dresco/ChickenShack/hardware/manufacturing/README

Notes:

Directory contains symlinks with correct naming convention
Move/copy board outline to silkscreen layer
Add order number to silkscreen layer
Zip up as ordernumber_size.zip (i.e. D12345_5x5.zip)
