dresco/ChickenShack/(list of files, drawings)

Other design files:
hardware/ChickenShack.dsn
