dresco/ChickenShack/hardware/ChickenShack.sch

## KiCad design hardware/ChickenShack.sch (2013-01-05)

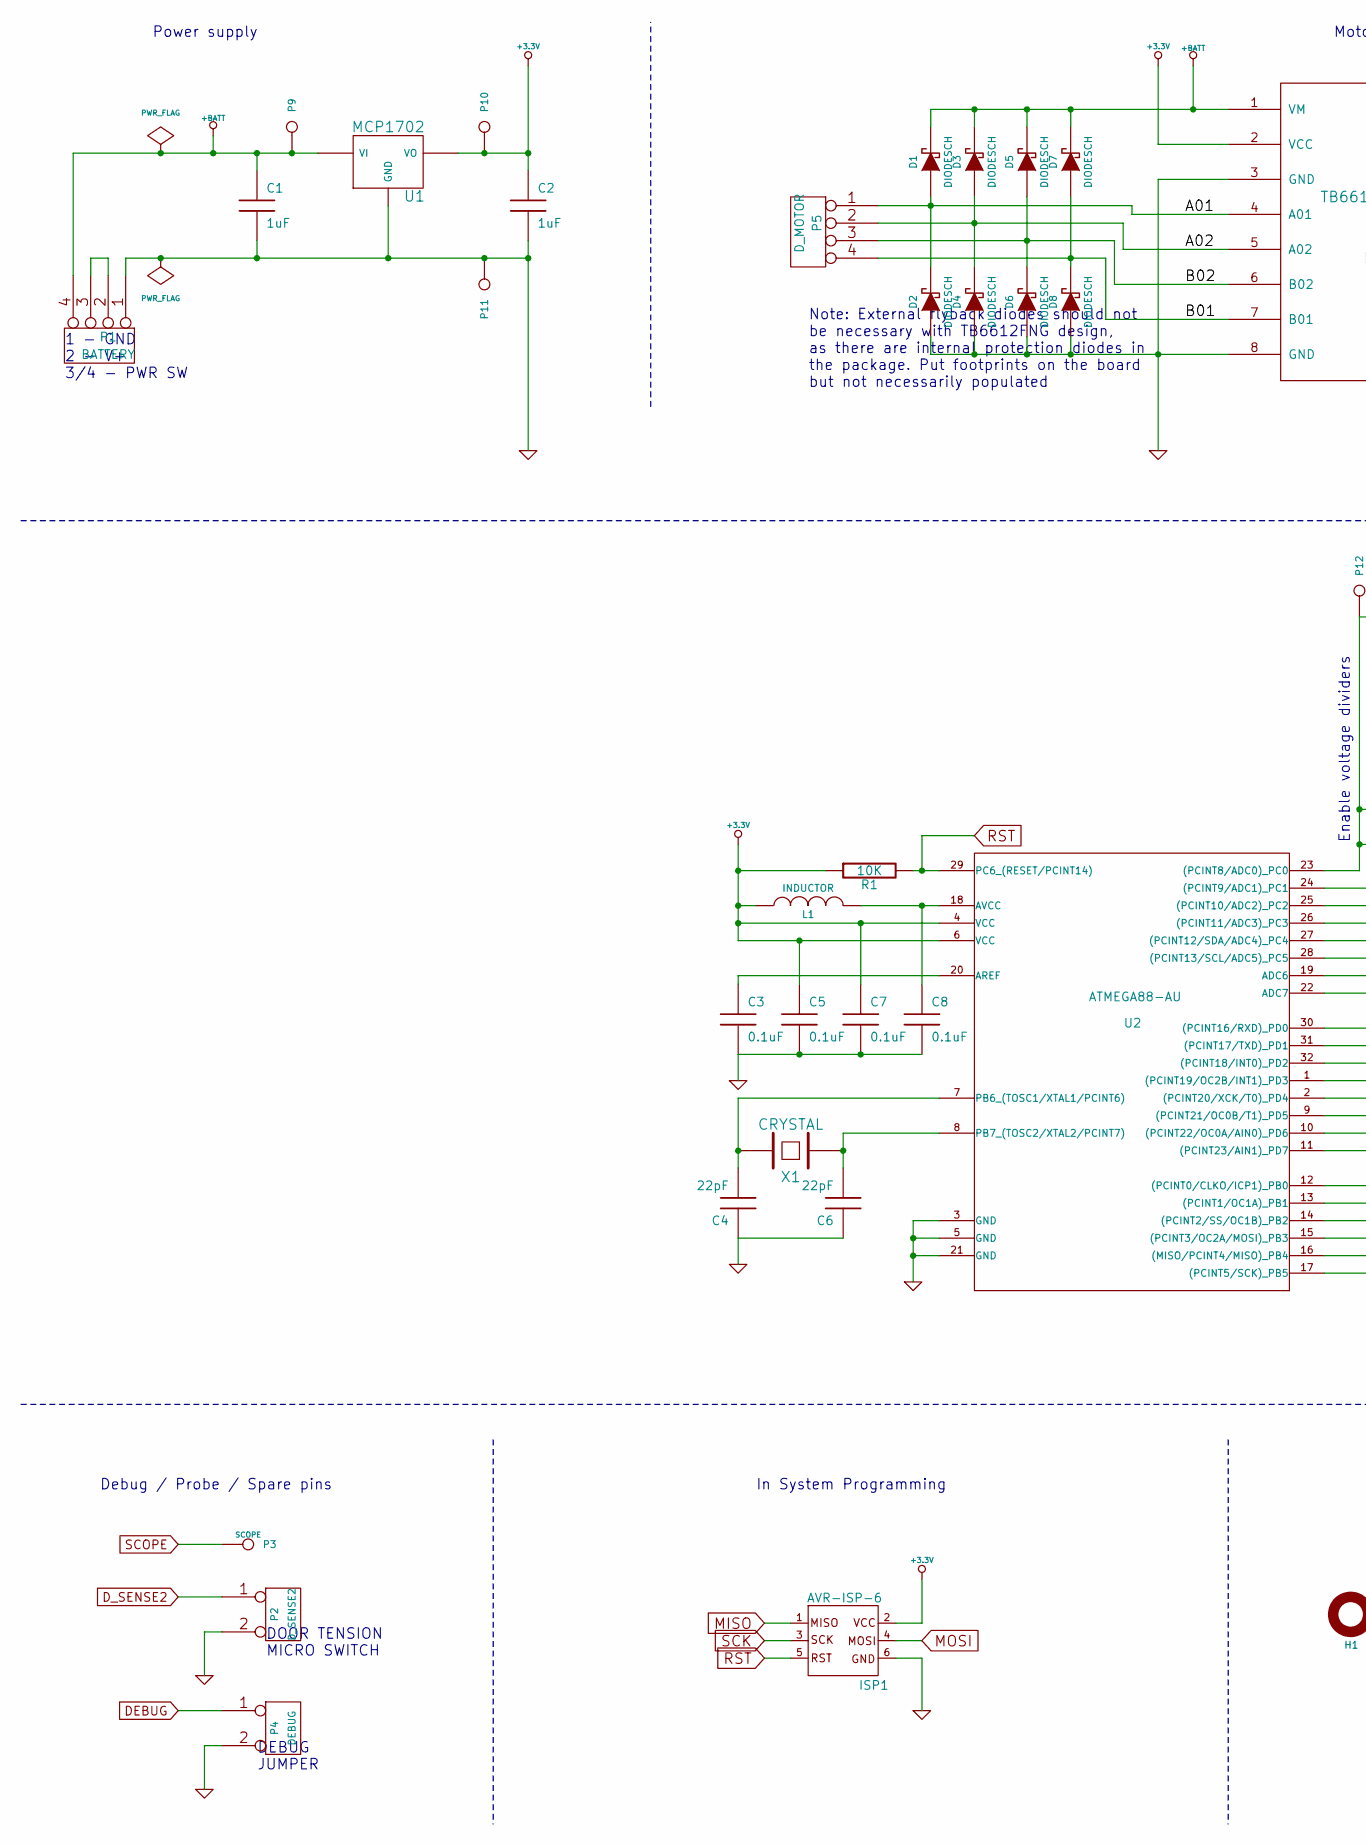
[picture p1: schematic ChickenShack.sch, part in row 1, column 1]

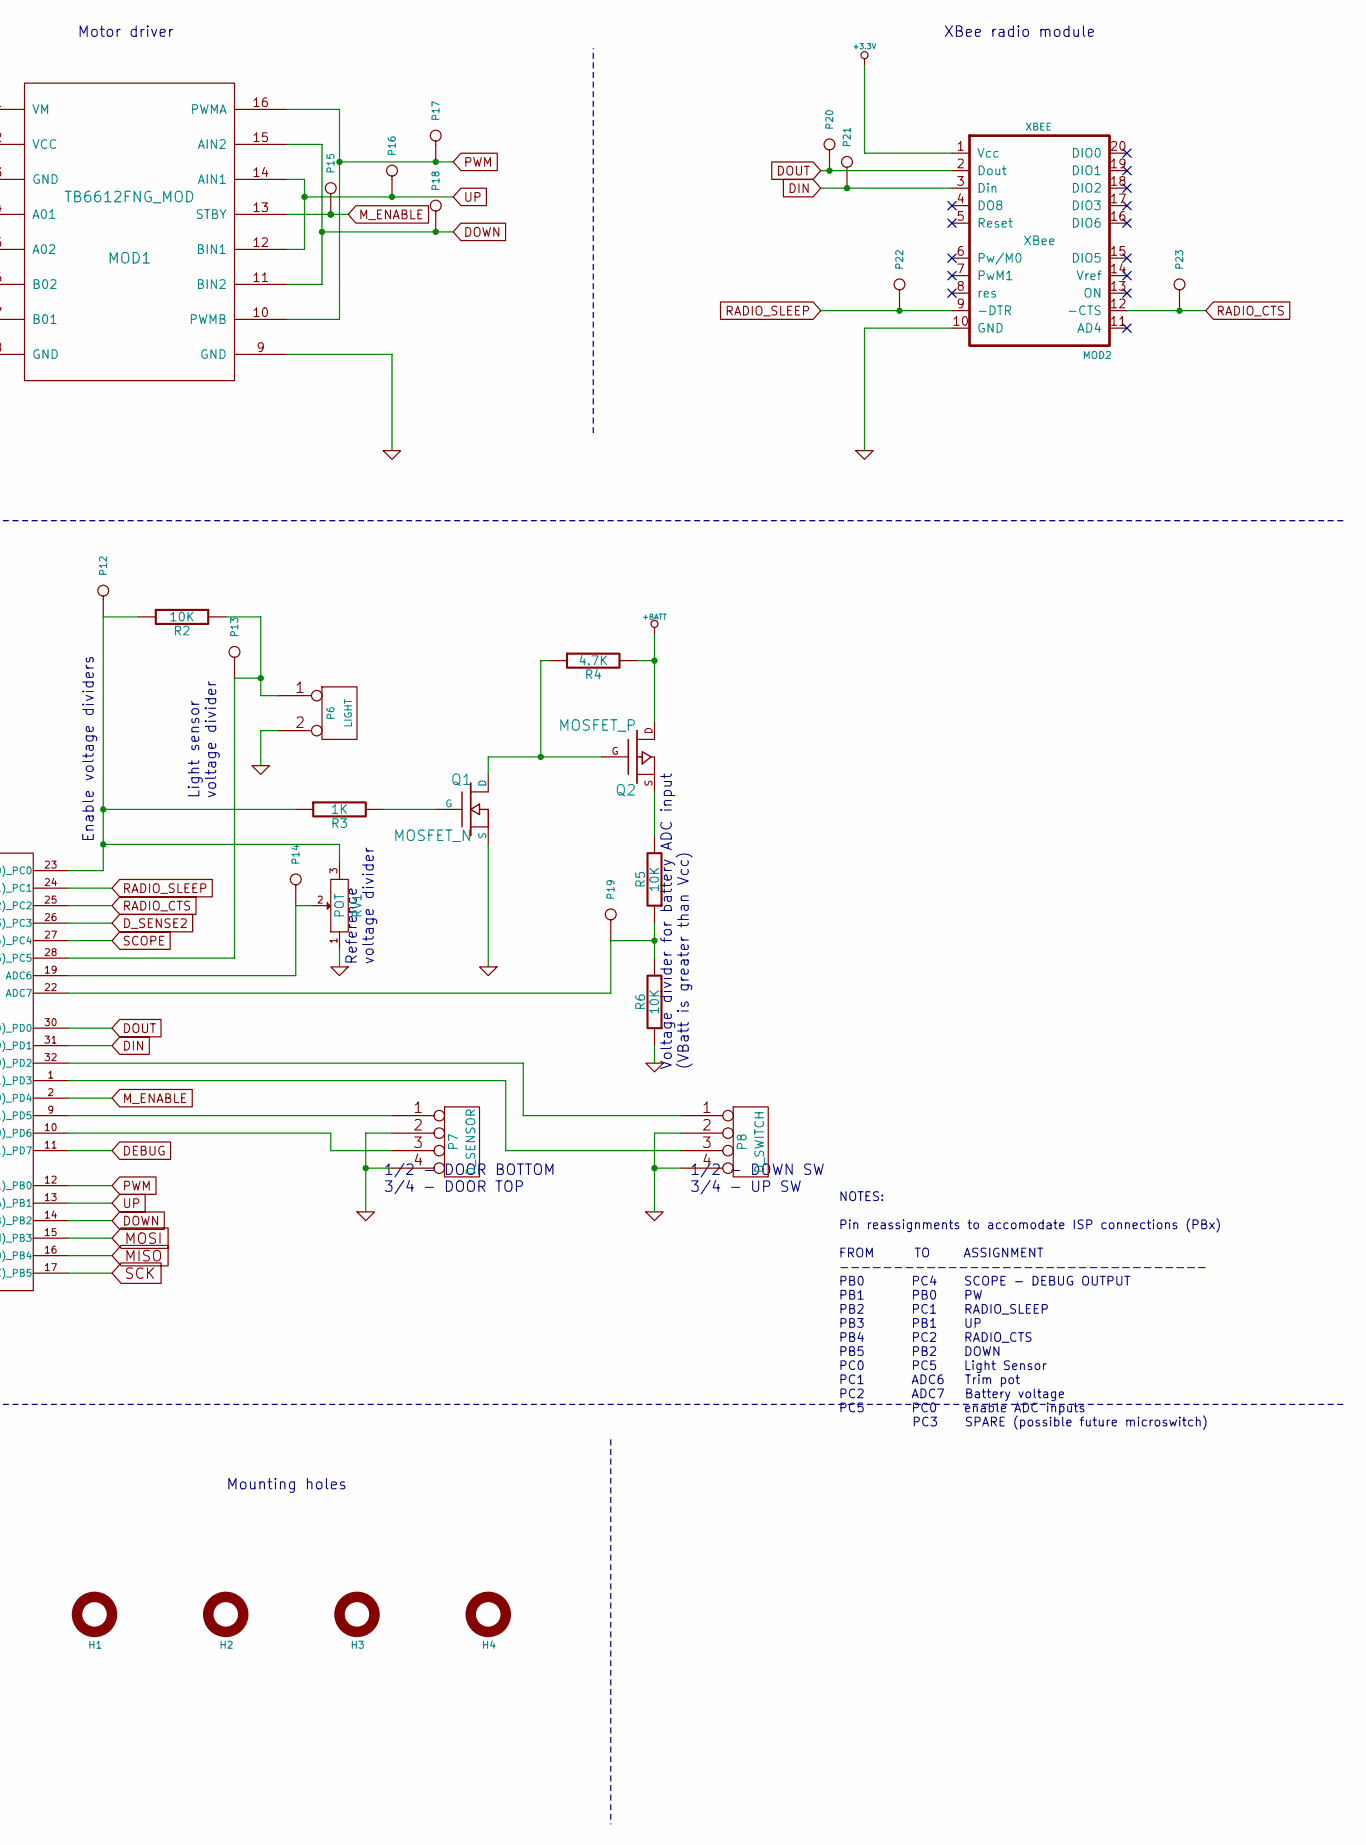
[picture p2: schematic ChickenShack.sch, part in row 1, column 2]

Parts:
C1, C2: 1uF
C3, C5, C7, C8: 0.1uF
C4, C6: 22pF
D1, D2, D3, D4, D5, D6, D7, D8: DIODESCH
H1, H2, H3, H4: HOLE
ISP1: AVR-ISP-6
L1: INDUCTOR
MOD1: TB6612FNG_MOD
MOD2: XBEE; XBee
P1: BATTERY
P2: D_SENSE2
P3: SCOPE
P4: DEBUG
P5: D_MOTOR
P6: LIGHT
P7: D_SENSOR
P8: D_SWITCH
P9, P10, P11, P12, P13, P14, P15, P16, P17, P18, P19, P20, P21, P22, P23: CONN_1
Q1: MOSFET_N
Q2: MOSFET_P
R1, R2, R5, R6: 10K
R3: 1K
R4: 4.7K
RV1: POT
U1: MCP1702
U2: ATMEGA88-AU
X1: CRYSTAL

Connections:
+3.3V: C2.1, C5.1, C7.1, ISP1.2, L1.1, MOD1.2 (VCC), MOD2.1 (Vcc), P10.1, R1.1, U1.VO, U2.4 (VCC), U2.6 (VCC)
+BATT: C1.1, D1.2 (K), D3.2 (K), D5.2 (K), D7.2 (K), MOD1.1 (VM), P1.4, P9.1, Q2.D, R4.2, U1.VI
A01: D1.1 (A), D2.2 (K), MOD1.4 (A01), P5.1
A02: D3.1 (A), D4.2 (K), MOD1.5 (A02), P5.2
B01: D7.1 (A), D8.2 (K), MOD1.7 (B01), P5.4
B02: D5.1 (A), D6.2 (K), MOD1.6 (B02), P5.3
DEBUG: P4.1, U2.11 ((PCINT23/AIN1)_PD7)
DIN: MOD2.3 (Din), P21.1, U2.31 ((PCINT17/TXD)_PD1)
DOUT: MOD2.2 (Dout), P20.1, U2.30 ((PCINT16/RXD)_PD0)
DOWN: MOD1.11 (BIN2), MOD1.15 (AIN2), P18.1, U2.14 ((PCINT2/SS/OC1B)_PB2)
D_SENSE2: P2.1, U2.26 ((PCINT11/ADC3)_PC3)
GND: C1.2, C2.2, C3.2, C4.1, C5.2, C6.1, C7.2, C8.2, D2.1 (A), D4.1 (A), D6.1 (A), D8.1 (A), ISP1.6, MOD1.3 (GND), MOD1.8 (GND), MOD1.9 (GND), MOD2.10 (GND), P1.1, P2.2 (PM), P4.2 (PM), P6.2 (PM), P7.2, P7.4, P8.2, P8.4, P11.1, Q1.S, R6.1, RV1.1, U1.GND, U2.3 (GND), U2.5 (GND), U2.21 (GND)
MISO: ISP1.1, U2.16 ((MISO/PCINT4/MISO)_PB4)
MOSI: ISP1.4, U2.15 ((PCINT3/OC2A/MOSI)_PB3)
M_ENABLE: MOD1.13 (STBY), P15.1, U2.2 ((PCINT20/XCK/T0)_PD4)
unnamed: C3.1, U2.20 (AREF)
unnamed: C4.2, U2.7 (PB6_(TOSC1/XTAL1/PCINT6)), X1.2
unnamed: C6.2, U2.8 (PB7_(TOSC2/XTAL2/PCINT7)), X1.1
unnamed: C8.1, L1.2, U2.18 (AVCC)
unnamed: P1.2, P1.3
unnamed: P7.1, U2.9 ((PCINT21/OC0B/T1)_PD5)
unnamed: P7.3, U2.10 ((PCINT22/OC0A/AIN0)_PD6)
unnamed: P8.1, U2.32 ((PCINT18/INT0)_PD2)
unnamed: P8.3, U2.1 ((PCINT19/OC2B/INT1)_PD3)
unnamed: P12.1, R2.2, R3.1, RV1.3, U2.23 ((PCINT8/ADC0)_PC0)
unnamed: P6.1, P13.1, R2.1, U2.28 ((PCINT13/SCL/ADC5)_PC5)
unnamed: P14.1, RV1.2, U2.19 (ADC6)
unnamed: P19.1, R5.1, R6.2, U2.22 (ADC7)
unnamed: Q1.D, Q2.G, R4.1
unnamed: Q1.G, R3.2
unnamed: Q2.S, R5.2
PWM: MOD1.10 (PWMB), MOD1.16 (PWMA), P17.1, U2.12 ((PCINT0/CLKO/ICP1)_PB0)
RADIO_CTS: MOD2.12 (-CTS), P23.1, U2.25 ((PCINT10/ADC2)_PC2)
RADIO_SLEEP: MOD2.9 (-DTR), P22.1, U2.24 ((PCINT9/ADC1)_PC1)
RST: ISP1.5, R1.2, U2.29 (PC6_(RESET/PCINT14))
SCK: ISP1.3, U2.17 ((PCINT5/SCK)_PB5)
SCOPE: P3.1, U2.27 ((PCINT12/SDA/ADC4)_PC4)
UP: MOD1.12 (BIN1), MOD1.14 (AIN1), P16.1, U2.13 ((PCINT1/OC1A)_PB1)

Notes on the sheet:
DOOR TENSION MICRO SWITCH
Mounting holes
Note: External flyback diodes should not be necessary with TB6612FNG design, as there are internal protection diodes in the package. Put footprints on the board but not necessarily populated
Light sensor voltage divider
Reference voltage divider
Enable voltage dividers
Debug / Probe / Spare pins
Motor driver
XBee radio module
Power supply
In System Programming
Voltage divider for battery ADC input (VBatt is greater than Vcc)
1/2 - DOWN SW 3/4 - UP SW
1/2 - DOOR BOTTOM 3/4 - DOOR TOP
DEBUG JUMPER
1 - GND 2 - V+ 3/4 - PWR SW
NOTES: Pin reassignments to accomodate ISP connections (PBx) FROM TO ASSIGNMENT ---------------------------------- PB0 PC4 SCOPE - DEBUG OUTPUT PB1 PB0 PW PB2 PC1 RADIO_SLEEP PB3 PB1 UP PB4 PC2 RADIO_CTS PB5 PB2 DOWN PC0 PC5 Light Sensor PC1 ADC6 Trim pot PC2 ADC7 Battery voltage PC5 PC0 enable ADC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
