dresco/ChickenShack/(commit log)

2011-11-18 Initial import of source code and PCB design files
    [ChickenShack-ar.brd, ChickenShack.brd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]
2011-11-18 Move initial door positioning call before oscillator calibration at startup, will ensure door is moved to correct position even if timer2 stops running and system is being restarted by watchdog timer.
    [chickenshack.c]
2012-12-16 Conditionally compile the OSCCAL calibration code - as workaround for hardware issues with the watch crystal circuit.
    [chickenshack.c]
2012-12-16 Additional comments following issues with watch crystal circuit
    [chickenshack.c]
2012-12-30 AVCC and AREF connections were reversed on the schematic (the tracks were cut and connections bodged on the original PCB order)
    [ChickenShack.sch]
2012-12-31 Start migration to SMD components, replace MCU & LDO in schematic
    [ChickenShack.sch]
2012-12-31 More schematic changes for SMD components, various pin changes to accomodate ISP header etc
    [ChickenShack.sch]
2013-01-01 SMD schematic and netlist updates
    [ChickenShack.sch]
2013-01-02 Schematic tweaks, netlist footprint mappings, start new board layout
    [ChickenShack.brd, ChickenShack.sch]
2013-01-05 More layout
    [ChickenShack.brd, ChickenShack.sch]
2013-01-05 Add test points, start routing PCB
    [ChickenShack.brd, ChickenShack.dsn, ChickenShack.sch]
2013-01-06 More board routing, delete unused component files.
    [ChickenShack-ar.brd, ChickenShack.brd, ChickenShack.dsn, nonamebrd.dsn]
2013-01-08 More layout, tweak board outline for easier mounting, generate gerbers for review, start silkscreen tidy ups
    [ChickenShack.brd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]
2013-01-12 More silkscreen tweaks
    [ChickenShack.brd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]
2013-01-12 Solder mask clearance hadn't been saved, edit in project file
    [ChickenShack-Back.gbl, ChickenShack-Front.gtl, ChickenShack-Mask_Back.gbs, ChickenShack-Mask_Front.gts, ChickenShack-PCB_Edges.gbr, ChickenShack-SilkS_Back.gbo, ChickenShack-SilkS_Front.gto]
2013-01-12 More silkscreen - add logo etc
    [ChickenShack.brd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]
2013-01-12 Add version and license info to board files
    [ChickenShack.brd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]
2013-01-13 Move ISP header away from XBee module for increased clearance
    [ChickenShack.brd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]
2013-01-13 Added README and symlinks with correct naming conventions for ITEAD pcb service
    [chickenshack.gbl, chickenshack.gbo, chickenshack.gbs, chickenshack.gtl, chickenshack.gto, chickenshack.gts]
2013-01-13 Move board outline to silkscreen layer - ready for ITEAD order
    [ChickenShack.brd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]
2013-01-13 v2.00 board packaged for ITEAD manufacturing. Board outline moved back to pcb edges layer.
    [ChickenShack.brd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]
2013-01-13 Firmware - add conditonal code to avoid the async timer2 parts, using the watchdog timer in interrupt mode instead. Is a workaround for the failing 32kHz crystal circuit on v1.0 board
    [chickenshack.c]
2014-02-13 Revert "Firmware - add conditonal code to avoid the async timer2 parts"
    Removing the watchdog workaround for the 32kHz crystal issue
    This reverts commit a01aeabe212f80f5bb09ae7523f6d36f606daef9.
    [chickenshack.c]
2014-02-13 Pin reassignments for v2 board -
    PB0 to PC4
2014-02-13 Pin reassignments for v2 board -
    PB1 to PB0
2014-02-13 Pin reassignments for v2 board -
    PC1 to ADC6
    PC2 to ADC7
2014-02-13 Pin reassignments for v2 board -
    PB2 to PC1
2014-02-13 Pin reassignments for v2 board -
    PB3 to PB1
2014-02-13 Pin reassignments for v2 board -
    PB4 to PC2
2014-02-13 Pin reassignments for v2 board -
    PB5 to PB2
2014-02-13 Pin reassignments for v2 board -
    PC0 to PC5
    PC5 to PC0
2014-02-14 Update hardcoded OSCCAL for new board
2014-02-15 Re-enable runtime OSCCAL calibration
    Initial calibration moved after watchdog setup - resolves an issue
    that if the crystal circuit fails, we may never get past the initial
    calbration routine, and therefore never set up the watchdog timer.
    [chickenshack.c]
2014-02-15 Update battery ADC calculations
    New resister values in voltage divider
2015-09-12 Door sometimes slipping down under it's own weight.
    Put the motor driver IC driver into 'short brake' instead of 'standby'
    (increases power budget by ~1.5mA)
    [chickenshack.c]
2015-11-21 Power saving, only enable 'short brake' during daytime
    [chickenshack.c]
2019-07-13 Revert "Power saving, only enable 'short brake' during daytime"
    This reverts commit c34ffe996d53f877630b1a39ec93af6da1aaa3f6.
    [chickenshack.c]
2019-07-13 Revert "Door sometimes slipping down under it's own weight."
    This reverts commit 5986e9ffdd56120c80fab1887b6cb3a9dec582ce.
    [chickenshack.c]
2019-07-13 Update TODO list
    Source and drain connections on Q2 (the p-channel mosfet for high side
    switching of battery monitoring voltage divider) are inverted on schematic.
    May change to an always-on high resistance voltage divider with small cap
    to provide sufficient current during ADC sampling..
