dresco/ChickenShack/(notices)

Notices in the files:
hardware/ChickenShack.sch:
Released under Creative Commons Attribution-Sharealike (CC BY-SA 3.0) license
